concept-code-design/Freaq-FM-mod/hardware/Freaq v1.2.kicad_pcb

## KiCad design hardware/Freaq v1.2.kicad_pcb (2026-10-27)

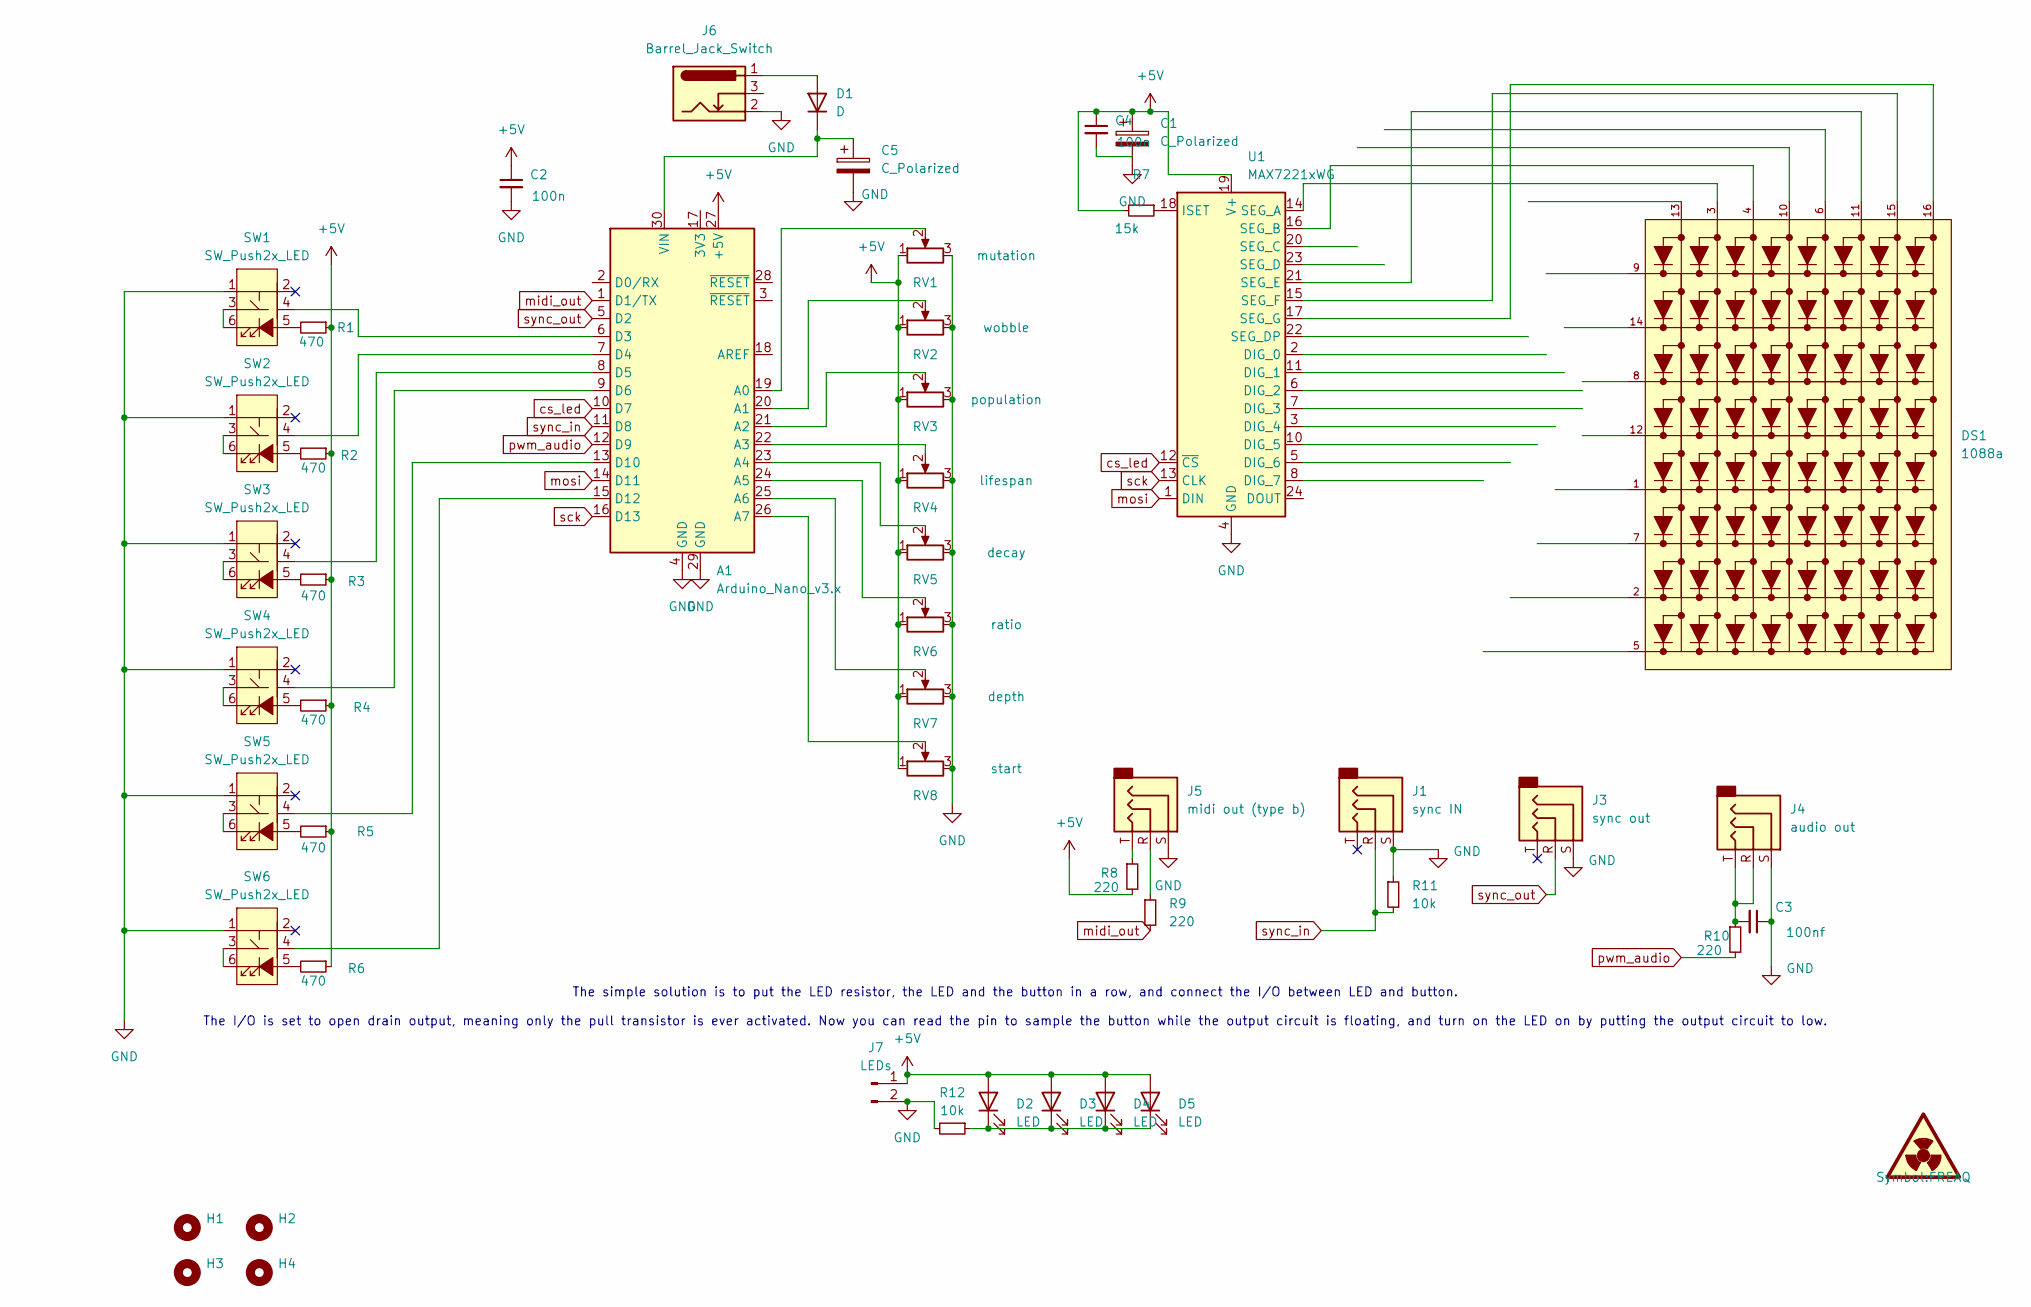
[picture p1: schematic Freaq v1.2.kicad_sch]

Parts:
A1: Arduino_Nano_v3.x; Arduino_Nano
C1, C5: C_Polarized; CP_Elec_8x6.5
C2, C4: 100n; C_1206_3216Metric_Pad1.33x1.80mm_HandSolder
C3: 100nf; C_1206_3216Metric_Pad1.33x1.80mm_HandSolder
D1: D; D_SMB
D2, D3, D4, D5: LED; LED_0805_2012Metric
DS1: 1088a; DISPLAY_1088a; PARTREV V.11A
H1, H2, H3, H4: MountingHole; MountingHole_3.2mm_M3
J1: sync IN; Jack_3.5mm_PJ320D_Horizontal
J3: sync out; Jack_3.5mm_PJ320D_Horizontal
J4: audio out; Jack_3.5mm_PJ320D_Horizontal
J5: midi out (type b); Jack_3.5mm_PJ320D_Horizontal
J6: Barrel_Jack_Switch; BarrelJack_3.5mm_Ali
J7: LEDs; PinHeader_1x02_P2.54mm_Horizontal
R1, R2, R3, R4, R5, R6: 470; R_1206_3216Metric_Pad1.30x1.75mm_HandSolder
R7: 15k; R_1206_3216Metric_Pad1.30x1.75mm_HandSolder
R8, R9, R10: 220; R_1206_3216Metric_Pad1.30x1.75mm_HandSolder
R11, R12: 10k; R_1206_3216Metric_Pad1.30x1.75mm_HandSolder
RV1: mutation; Pot_Alpha_RD901F-ALI
RV2: wobble; Pot_Alpha_RD901F-ALI
RV3: population; Pot_Alpha_RD901F-ALI
RV4: lifespan; Pot_Alpha_RD901F-ALI
RV5: decay; Pot_Alpha_RD901F-ALI
RV6: ratio; Pot_Alpha_RD901F-ALI
RV7: depth; Pot_Alpha_RD901F-ALI
RV8: start; Pot_Alpha_RD901F-ALI
SW1, SW2, SW3, SW4, SW5, SW6: SW_Push2x_LED; SW_PUSH-12mm_LED
U1: MAX7221xWG; SOIC-24W_7.5x15.4mm_P1.27mm

Connections:
+5V: A1.27 (+5V), C1.1, C2.1, C4.1, D2.2 (A), D3.2 (A), D4.2 (A), D5.2 (A), J7.1, R1.1, R2.1, R3.1, R4.1, R5.1, R6.1, R7.2, R8.2, RV1.1, RV2.1, RV3.1, RV4.1, RV5.1, RV6.1, RV7.1, RV8.1, U1.19 (V+)
GND: A1.4 (GND), A1.29 (GND), C1.2, C2.2, C3.1, C5.2, J1.S, J3.S, J4.S, J5.S, J6.2, J7.2, R11.1, R12.2, RV1.3, RV2.3, RV3.3, RV4.3, RV5.3, RV6.3, RV7.3, RV8.3, SW1.1, SW2.1, SW3.1, SW4.1, SW5.1, SW6.1, U1.4 (GND), U1.9 (GND)
unnamed: A1.19 (A0), RV1.2
unnamed: A1.20 (A1), RV2.2
unnamed: A1.21 (A2), RV3.2
unnamed: A1.22 (A3), RV4.2
unnamed: A1.23 (A4), RV5.2
unnamed: A1.24 (A5), RV6.2
unnamed: A1.25 (A6), RV7.2
unnamed: A1.26 (A7), RV8.2
unnamed: A1.6 (D3), SW1.4 (2)
unnamed: A1.7 (D4), SW2.4 (2)
unnamed: A1.8 (D5), SW3.4 (2)
unnamed: A1.9 (D6), SW4.4 (2)
unnamed: A1.13 (D10), SW5.4 (2)
unnamed: A1.15 (D12), SW6.4 (2)
unnamed: A1.30 (VIN), C5.1, D1.1 (K)
unnamed: C3.2, J4.R, J4.T, R10.1
unnamed: D1.2 (A), J6.1
unnamed: D2.1 (K), D3.1 (K), D4.1 (K), D5.1 (K), R12.1
unnamed: J5.R, R9.1
unnamed: J5.T, R8.1
unnamed: R1.2, SW1.5 (A)
unnamed: SW1.3 (1), SW1.6 (K)
unnamed: R2.2, SW2.5 (A)
unnamed: SW2.3 (1), SW2.6 (K)
unnamed: R3.2, SW3.5 (A)
unnamed: SW3.3 (1), SW3.6 (K)
unnamed: R4.2, SW4.5 (A)
unnamed: SW4.3 (1), SW4.6 (K)
unnamed: R5.2, SW5.5 (A)
unnamed: SW5.3 (1), SW5.6 (K)
unnamed: R6.2, SW6.5 (A)
unnamed: SW6.3 (1), SW6.6 (K)
unnamed: DS1.9, U1.2 (DIG_0)
unnamed: DS1.14, U1.11 (DIG_1)
unnamed: DS1.8, U1.6 (DIG_2)
unnamed: DS1.12, U1.7 (DIG_3)
unnamed: DS1.1, U1.3 (DIG_4)
unnamed: DS1.7, U1.10 (DIG_5)
unnamed: DS1.2, U1.5 (DIG_6)
unnamed: DS1.5, U1.8 (DIG_7)
unnamed: R7.1, U1.18 (ISET)
unnamed: DS1.3, U1.14 (SEG_A)
unnamed: DS1.4, U1.16 (SEG_B)
unnamed: DS1.10, U1.20 (SEG_C)
unnamed: DS1.6, U1.23 (SEG_D)
unnamed: DS1.13, U1.22 (SEG_DP)
unnamed: DS1.11, U1.21 (SEG_E)
unnamed: DS1.15, U1.15 (SEG_F)
unnamed: DS1.16, U1.17 (SEG_G)
cs_led: A1.10 (D7), U1.12 (~CS)
midi_out: A1.1 (D1/TX), R9.2
mosi: A1.14 (D11), U1.1 (DIN)
pwm_audio: A1.12 (D9), R10.2
sck: A1.16 (D13), U1.13 (CLK)
sync_in: A1.11 (D8), J1.R, R11.2
sync_out: A1.5 (D2), J3.R

Notes on the sheet:
The simple solution is to put the LED resistor, the LED and the button in a row, and connect the I/O between LED and button. The I/O is set to open drain output, meaning only the pull transistor is ever activated. Now you can read the pin to sample the button while the output circuit is floating, a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

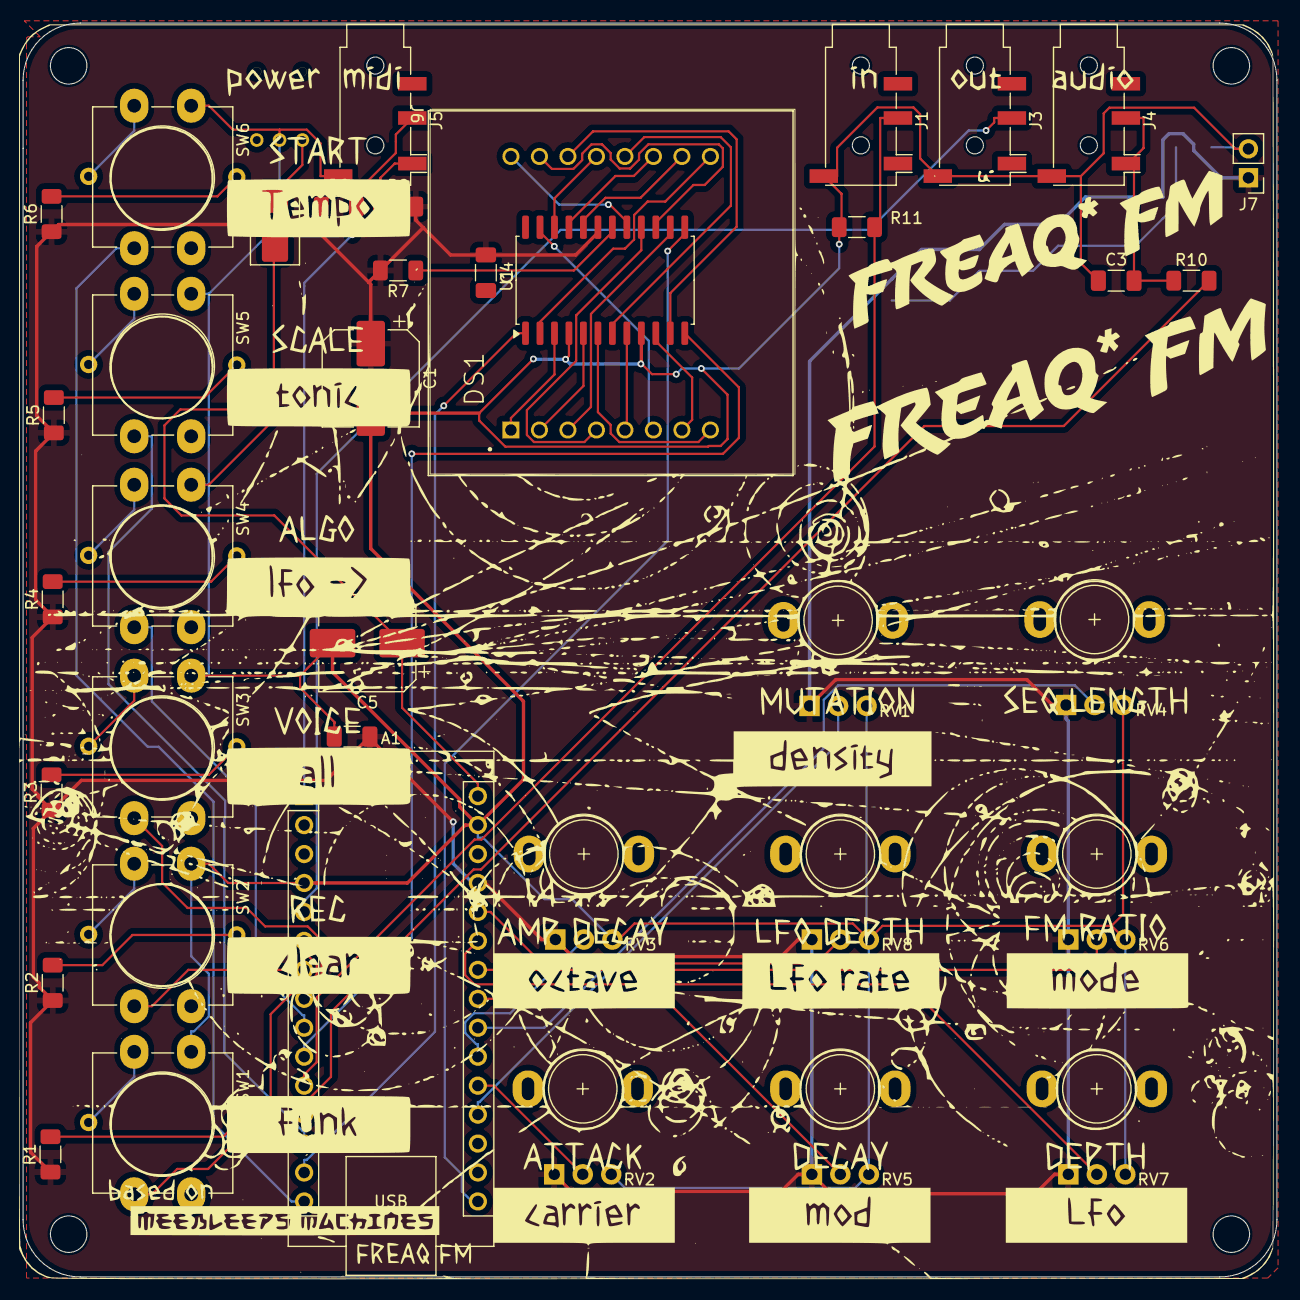
[picture p2: board Freaq v1.2.kicad_pcb from above]

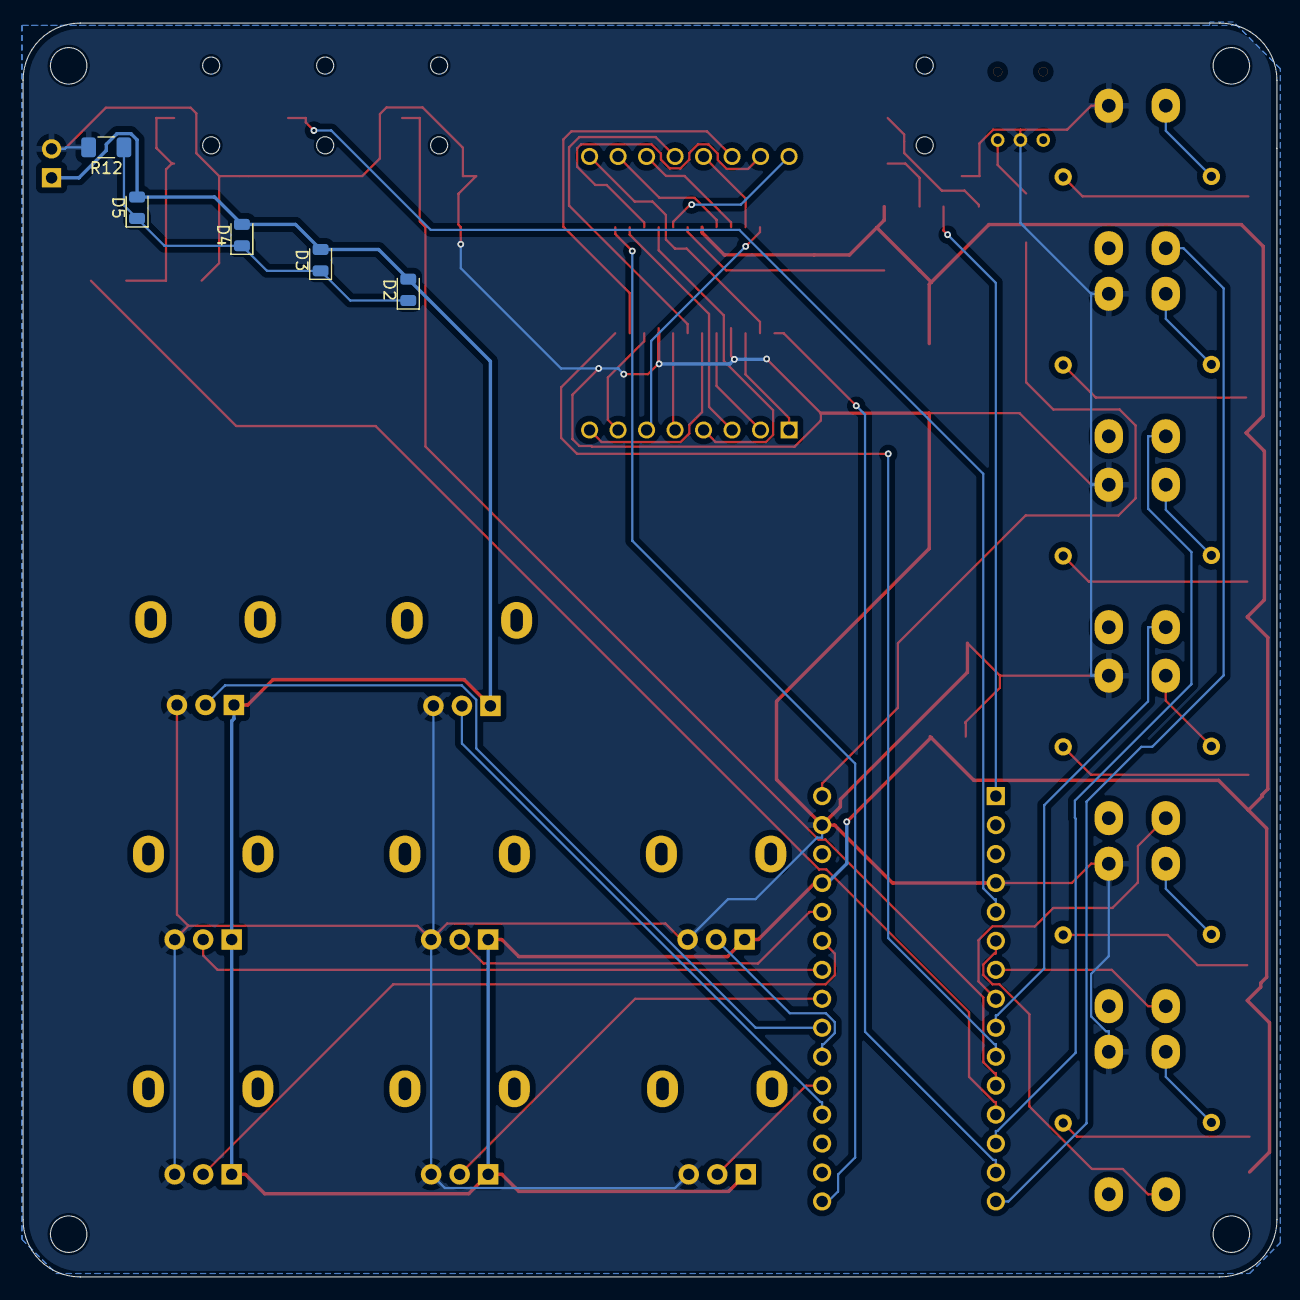
[picture p3: board Freaq v1.2.kicad_pcb from below]

Board: 2 copper layers, 110.0 x 110.0 mm, 51 parts (5 on the bottom side), 57 nets.

Other parts of the board:
FREAQ_brd: FREAQ name
FREAQ_panel: FREAQ* non neg
