concept-code-design/Freaq-FM-mod/hardware/Freaq v1 front panel.kicad_pcb

## KiCad design hardware/Freaq v1 front panel.kicad_pcb (2026-10-27)

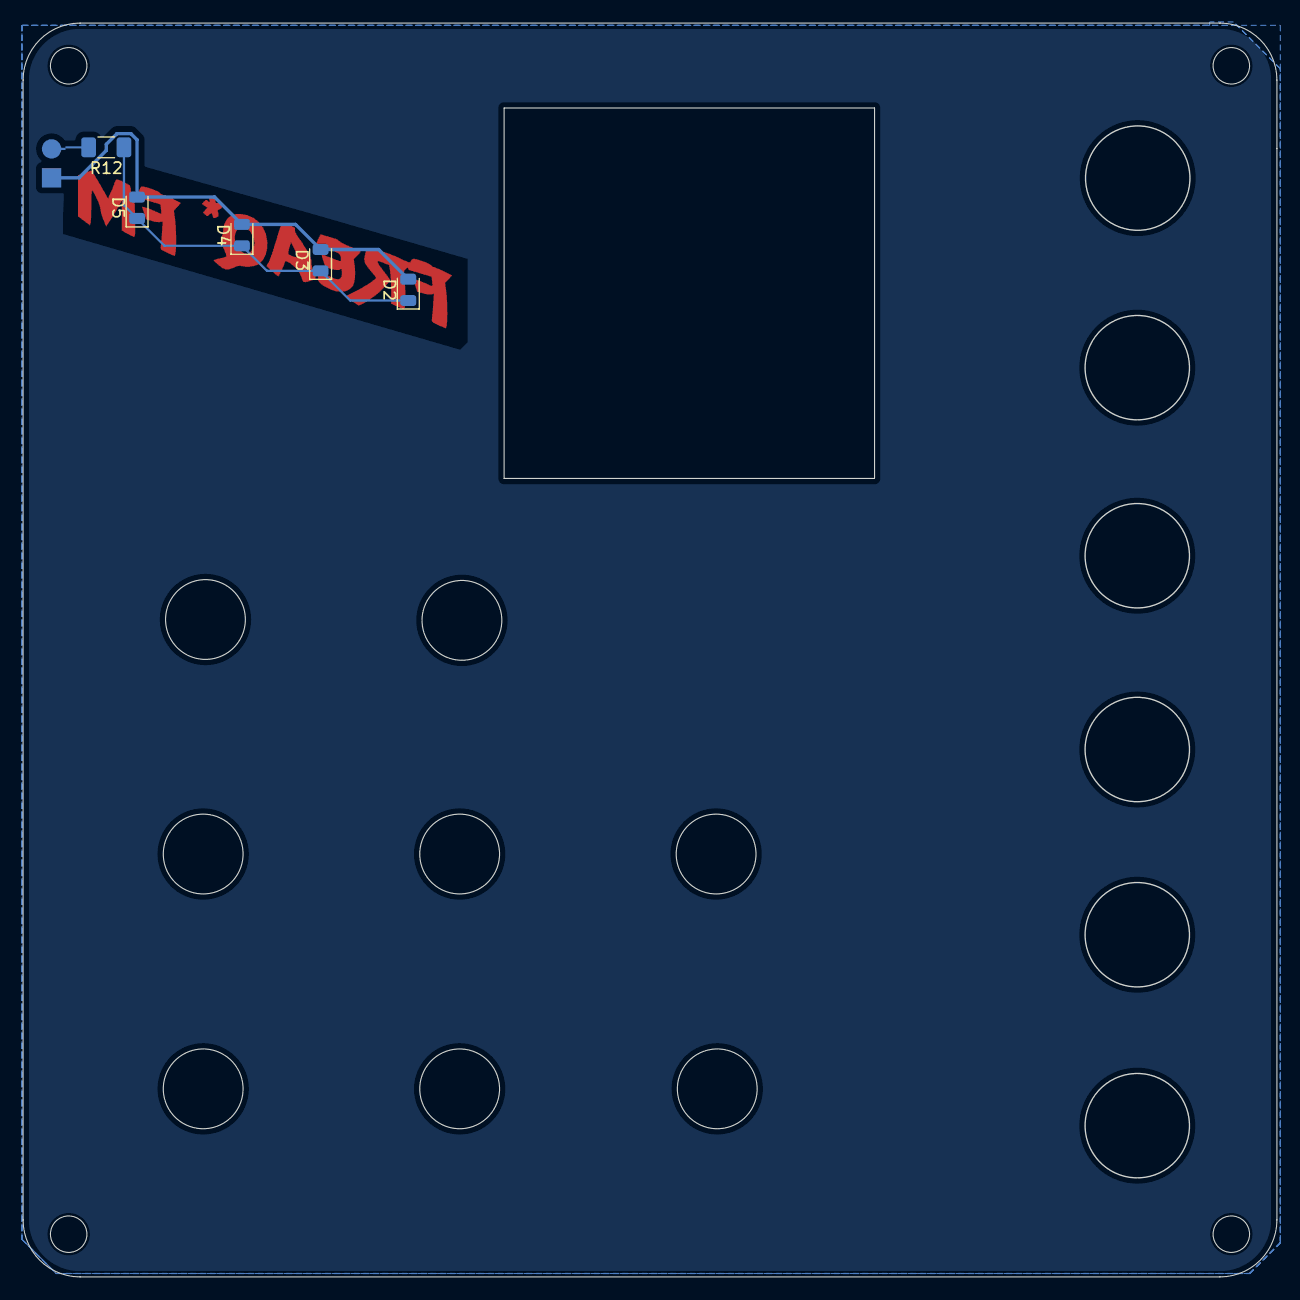
[picture p4: board Freaq v1 front panel.kicad_pcb from below]

Board: 2 copper layers, 110.0 x 110.0 mm, 27 parts (5 on the bottom side), 3 nets.

Parts:
D2, D3, D4, D5: LED; LED_0805_2012Metric
DS1: 1088a; DISPLAY_1088a
FREAQ_panel: FREAQ* non neg
Fcop: freaq copper
H1, H2, H3, H4: MountingHole; MountingHole_3.2mm_M3
J7: LEDs; PinHeader_1x02_P2.54mm_Vertical
R12: 10k; R_1206_3216Metric_Pad1.30x1.75mm_HandSolder
RV1: mutation; Pot_Alpha_RD901F-ALI-hole
RV2: wobble; Pot_Alpha_RD901F-ALI-hole
RV3: population; Pot_Alpha_RD901F-ALI-hole
RV4: lifespan; Pot_Alpha_RD901F-ALI-hole
RV5: decay; Pot_Alpha_RD901F-ALI-hole
RV6: ratio; Pot_Alpha_RD901F-ALI-hole
RV7: depth; Pot_Alpha_RD901F-ALI-hole
RV8: start; Pot_Alpha_RD901F-ALI-hole
SW6, SW6#2, SW6#3, SW6#4, SW6#5, SW6#6: SW_Push2x_LED; SW_PUSH-12mm_LED

Connections:
+5V: D2.2 (A), D3.2 (A), D4.2 (A), D5.2 (A), J7.1
GND: J7.2, R12.2
unnamed: D2.1 (K), D3.1 (K), D4.1 (K), D5.1 (K), R12.1
